Dong-quan/ESP32_IoT_Smart_Controller/Bai11.step

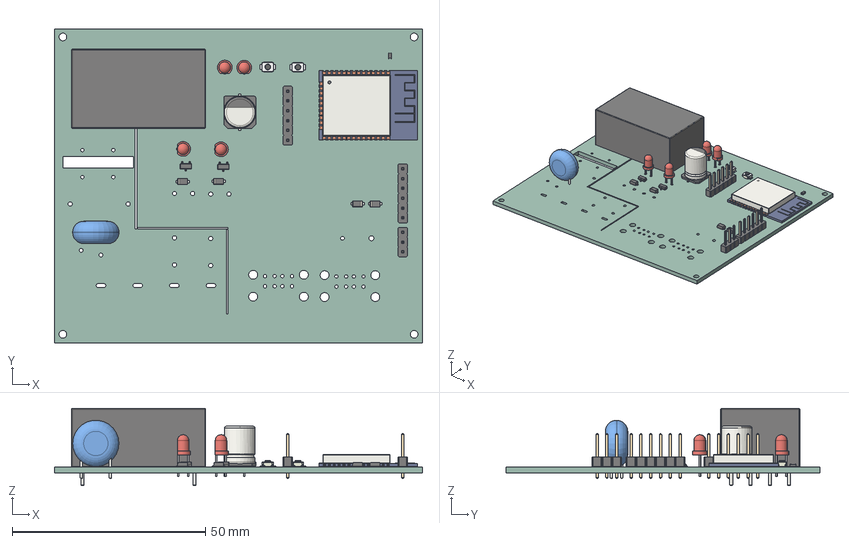
[picture p5: CAD file, 2026-10-30]
Bai11.step
95.3 x 81.3 x 20.0 mm
CP_Elec_8x10.5
ESP32-WROOM-32
SOT-23 x 2
D_SOD-123F x 4
RV_Disc_D12mm_W5.8mm_P7.5mm
LED_D3.0mm x 4
Converter_ACDC_Hi-Link_HLK-PMxx
SW_SPST_B3U-1000P x 2
D_0603_1608Metric
PinHeader_1x06_P2.54mm_Vertical x 2
PinHeader_1x03_P2.54mm_Vertical
Bai11_PCB
