Dong-quan/ESP32_IoT_Smart_Controller/Bai11.pdf

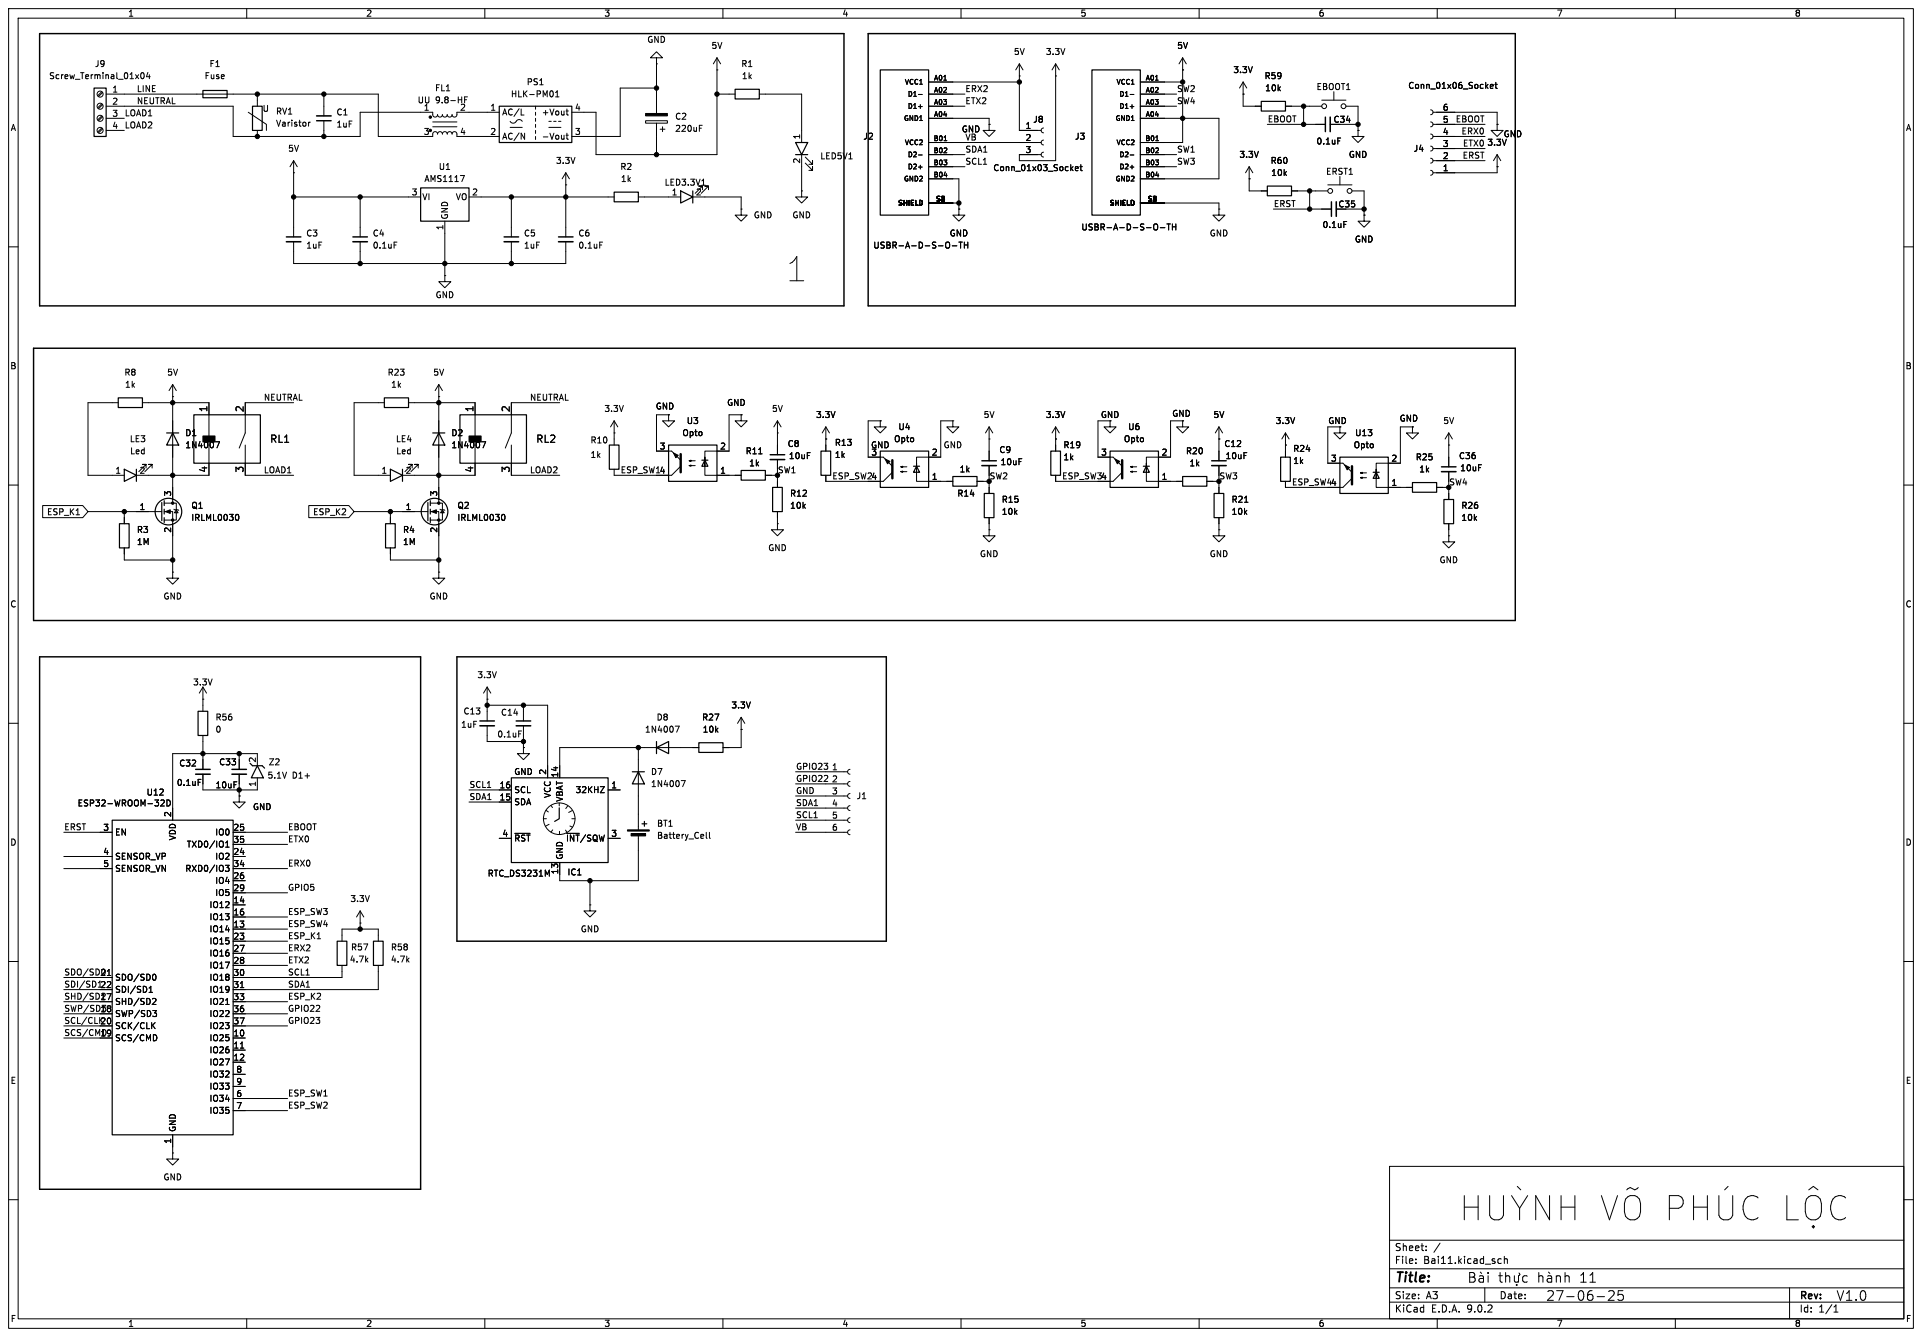
[picture p6: page 1]

þÿHUòNH þÿVÕþÿPHÚC þÿLØC
