Dong-quan/ESP32_IoT_Smart_Controller/Bai11.kicad_pcb

## KiCad design Bai11.kicad_pcb (2026-10-30)

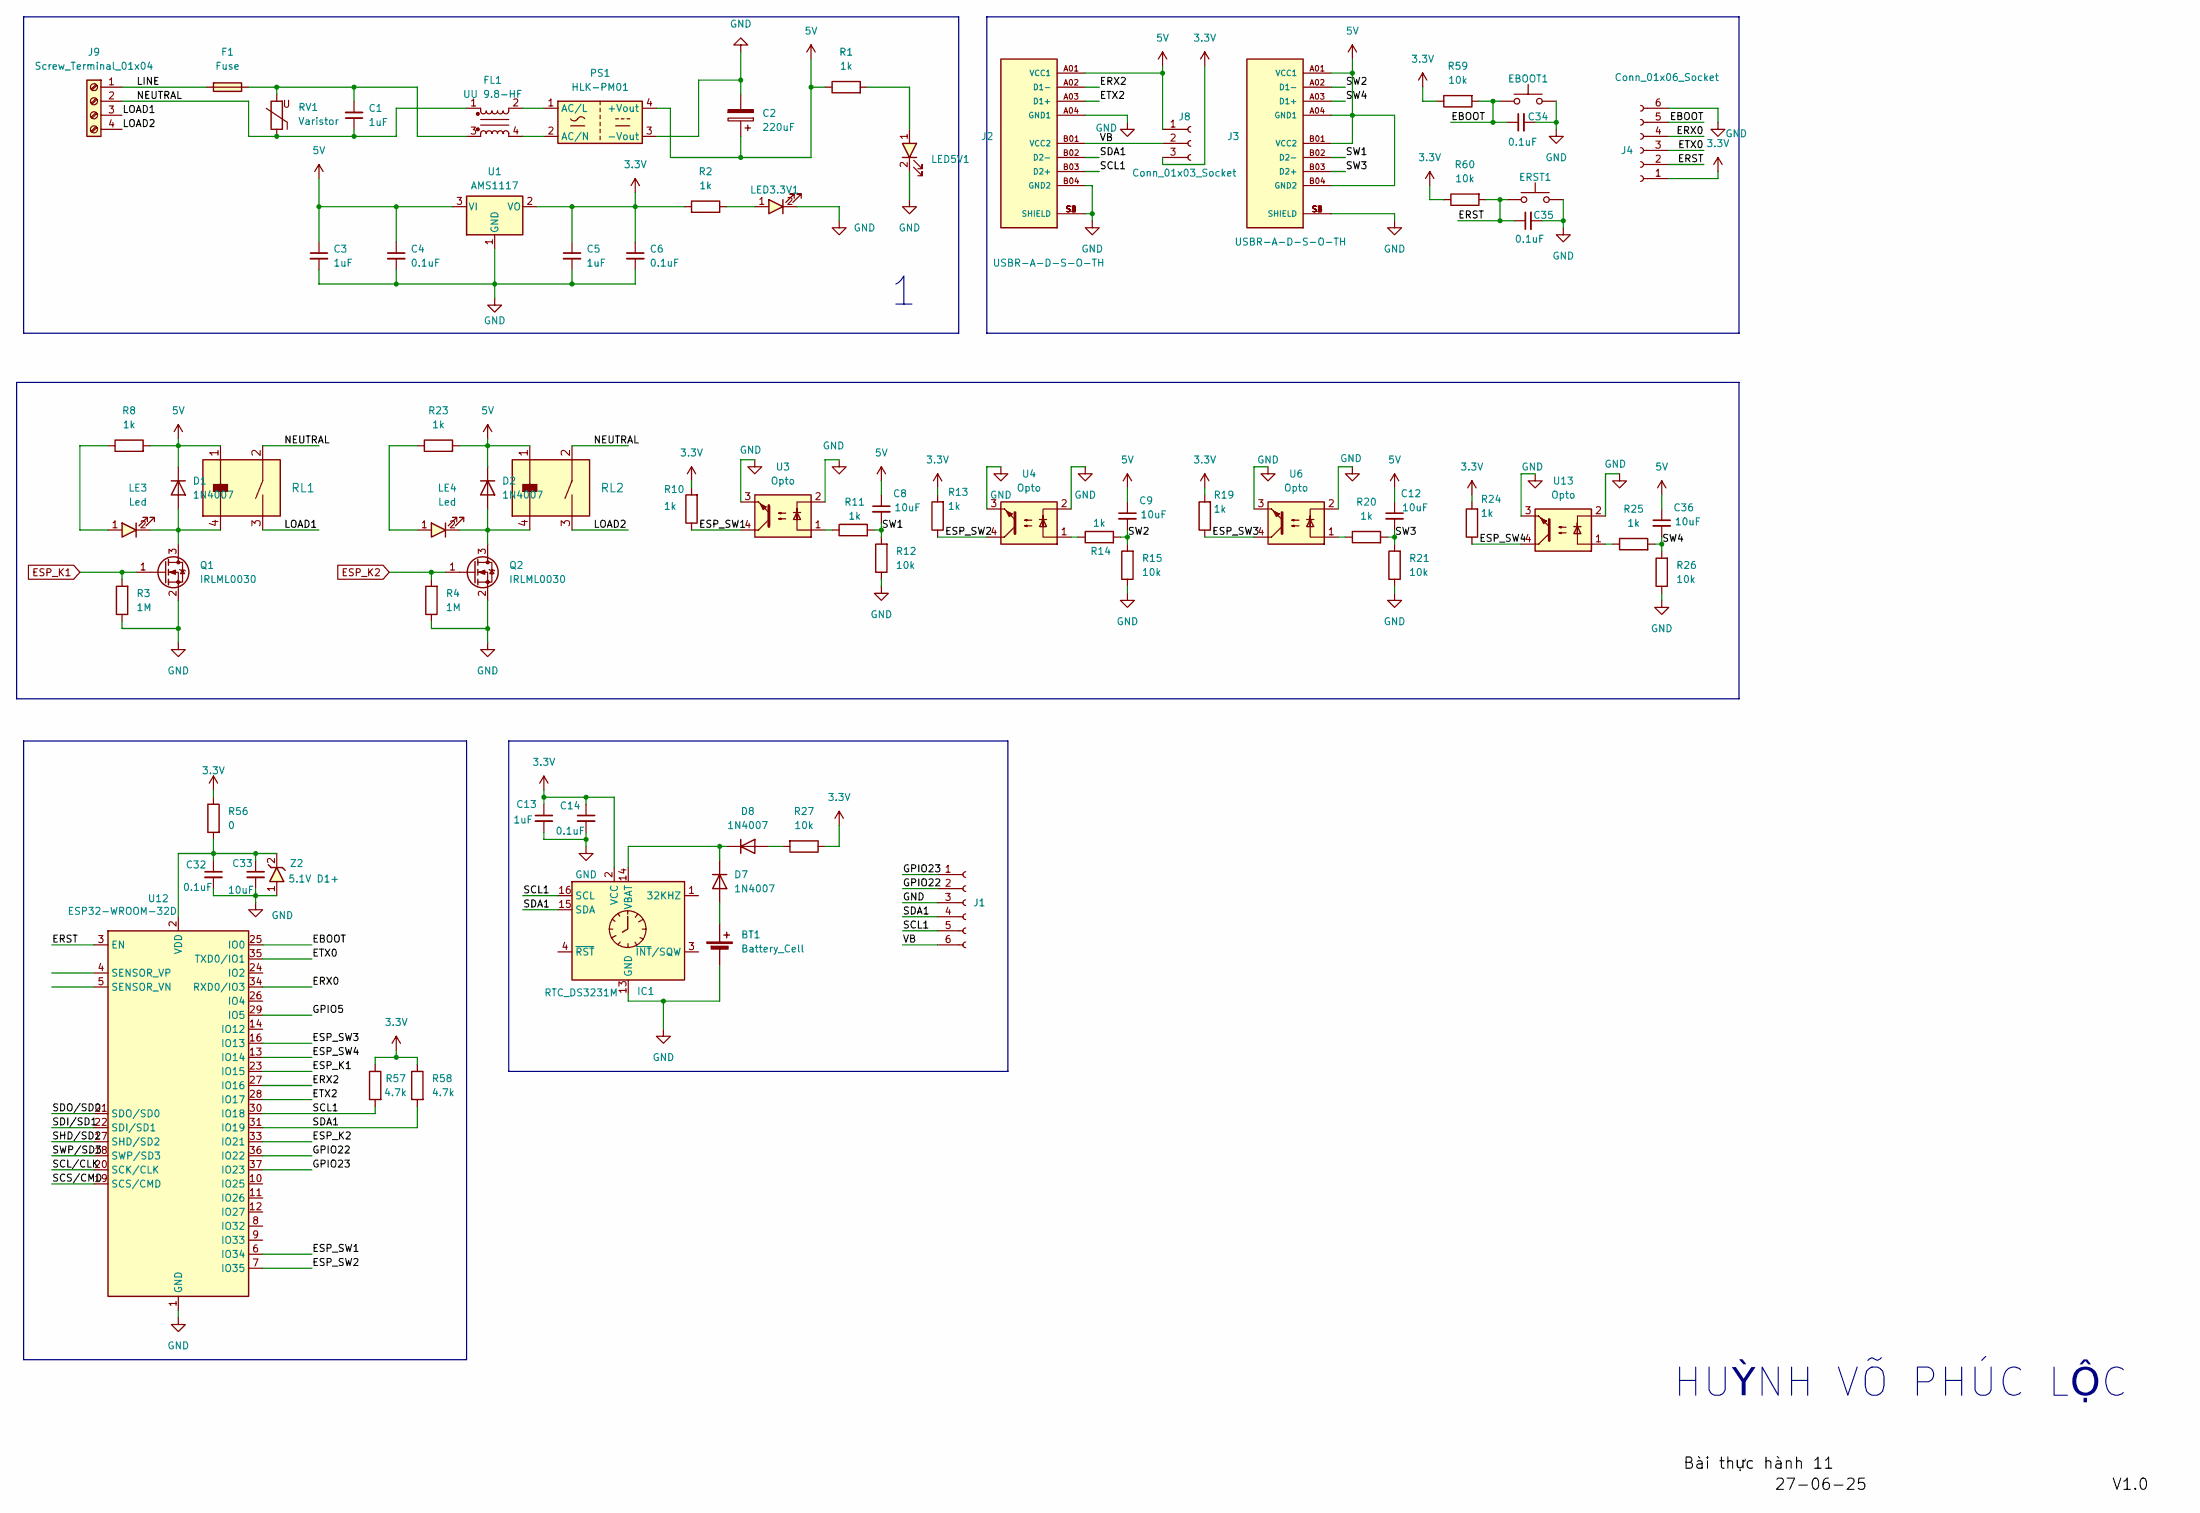
[picture p7: schematic Bai11.kicad_sch]

Parts:
BT1: Battery_Cell; BatteryHolder-SMD-CR1220
C1: 1uF; C-Polyester-Rect-L16.5mm-W5.0mm-P15.00mm-MKT
C2: 220uF; CP_Elec_8x10.5
C3, C5, C13: 1uF; C_0603
C4, C6, C14, C32, C34, C35: 0.1uF; C_0603
C8, C9, C12, C33, C36: 10uF; C_0603
D1, D2, D7, D8: 1N4007; D_SOD-123F
EBOOT1: SW_SPST_B3U-1000P
ERST1: SW_SPST_B3U-1000P
F1: Fuse; Fuse_Bourns_MF-RG300
FL1: UU 9.8-HF; ACFilterChoke-UU9.8
IC1: RTC_DS3231M; SOIC-16W_7.5x10.3mm_P1.27mm
J1, J4: Conn_01x06_Socket; PinHeader_1x06_P2.54mm_Vertical
J2, J3: USBR-A-D-S-O-TH; SAMTEC_USBR-A-D-S-O-TH
J8: Conn_01x03_Socket; PinHeader_1x03_P2.54mm_Vertical
J9: Screw_Terminal_01x04; TerminalBlock-Vert-THT-4P-P9.5mm-Screw_HB9500
LE3, LE4: Led; LED_D3.0mm
LED3.3V1, LED5V1: Led; LED_D3.0mm
PS1: HLK-PM01; Converter_ACDC_Hi-Link_HLK-PMxx
Q1, Q2: IRLML0030; SOT-23
R1, R2, R8, R10, R11, R13, R14, R19, R20, R23, R24, R25: 1k; R_0603
R3, R4: 1M; R_0603
R12, R15, R21, R26, R27, R59, R60: 10k; R_0603
R56: 0; R_0603
R57, R58: 4.7k; R_0603
RL1, RL2: Relay_G5NB-1A-E_DC5; Relay-G5NB_1A_E_DC5
RV1: Varistor; Varistor-RV-Disc-D12mm-W5.8mm-P7.5mm
U1: AMS1117; SOT233
U3, U4, U6, U13: Opto; OptoIsolation-EL357N-G
U12: ESP32-WROOM-32D; ESP32-WROOM-32E
Z2: 5.1V D1+; D_0603_1608Metric

Connections:
3.3V: C5.1, C6.1, C13.1, C14.1, IC1.2 (VCC), J4.1, J8.3, R2.1, R10.2, R13.2, R19.2, R24.2, R27.1, R56.1, R57.1, R58.1, R59.1, R60.1, U1.2 (VO)
5V: C2.1, C3.1, C4.1, C8.1, C9.1, C12.1, C36.1, D1.1 (K), D2.1 (K), J2.A01 (VCC1), J3.A01 (VCC1), J3.A04 (GND1), J3.B01 (VCC2), J3.B04 (GND2), J8.1, PS1.4 (+Vout), R1.1, R8.2, R23.2, RL1.1, RL2.1, U1.3 (VI)
/EBOOT: C34.1, EBOOT1.1, J4.5, R59.2, U12.25 (IO0)
/ERST: C35.1, ERST1.1, J4.2, R60.2, U12.3 (EN)
/ERX0: J4.4, U12.34 (RXD0/IO3)
/ERX2: J2.A02 (D1-), U12.27 (IO16)
/ESP_SW1: R10.1, U3.4, U12.6 (IO34)
/ESP_SW2: R13.1, U4.4, U12.7 (IO35)
/ESP_SW3: R19.1, U6.4, U12.16 (IO13)
/ESP_SW4: R24.1, U12.13 (IO14), U13.4
/ETX0: J4.3, U12.35 (TXD0/IO1)
/ETX2: J2.A03 (D1+), U12.28 (IO17)
/GPIO5: U12.29 (IO5)
/GPIO22: J1.2, U12.36 (IO22)
/GPIO23: J1.1, U12.37 (IO23)
/LINE: F1.1, J9.1
/LOAD1: J9.3, RL1.3
/LOAD2: J9.4, RL2.3
/NEUTRAL: C1.1, FL1.1, J9.2, RL1.2, RL2.2, RV1.1
/SCL1: IC1.16 (SCL), J1.5, J2.B03 (D2+), R57.2, U12.30 (IO18)
/SCL/CLK: U12.20 (SCK/CLK)
/SCS/CMD: U12.19 (SCS/CMD)
/SDA1: IC1.15 (SDA), J1.4, J2.B02 (D2-), R58.2, U12.31 (IO19)
/SDI/SD1: U12.22 (SDI/SD1)
/SDO/SD0: U12.21 (SDO/SD0)
/SHD/SD2: U12.17 (SHD/SD2)
/SW1: C8.2, J3.B02 (D2-), R11.2, R12.2
/SW2: C9.2, J3.A02 (D1-), R14.2, R15.2
/SW3: C12.2, J3.B03 (D2+), R20.2, R21.2
/SW4: C36.2, J3.A03 (D1+), R25.2, R26.2
/SWP/SD3: U12.18 (SWP/SD3)
/VB: J1.6, J2.B01 (VCC2), J8.2
ESP_K1: Q1.1 (G), R3.2, U12.23 (IO15)
ESP_K2: Q2.1 (G), R4.2, U12.33 (IO21)
GND: BT1.2 (-), C2.2, C3.2, C4.2, C5.2, C6.2, C13.2, C14.2, C32.2, C33.2, C34.2, C35.2, EBOOT1.2, ERST1.2, IC1.5 (GND), IC1.6 (GND), IC1.7 (GND), IC1.8 (GND), IC1.9 (GND), IC1.10 (GND), IC1.11 (GND), IC1.12 (GND), IC1.13 (GND), J1.3, J2.A04 (GND1), J2.B04 (GND2), J2.S1 (SHIELD), J2.S2 (SHIELD), J2.S3 (SHIELD), J2.S4 (SHIELD), J3.S1 (SHIELD), J3.S2 (SHIELD), J3.S3 (SHIELD), J3.S4 (SHIELD), J4.6, LED3.3V1.2, LED5V1.2, PS1.3 (-Vout), Q1.2 (S), Q2.2 (S), R3.1, R4.1, R12.1, R15.1, R21.1, R26.1, U1.1 (GND), U3.2, U3.3, U4.2, U4.3, U6.2, U6.3, U12.1 (GND), U12.15 (GND), U12.38 (GND), U12.39 (GND), U13.2, U13.3, Z2.1
unnamed: BT1.1 (+), D7.2 (A)
unnamed: C1.2, F1.2, FL1.3, RV1.2
unnamed: D1.2 (A), LE3.2, Q1.3 (D), RL1.4
unnamed: D2.2 (A), LE4.2, Q2.3 (D), RL2.4
unnamed: D7.1 (K), D8.1 (K), IC1.14 (VBAT)
unnamed: D8.2 (A), R27.2
unnamed: LE3.1, R8.1
unnamed: LE4.1, R23.1
unnamed: LED3.3V1.1, R2.2
unnamed: LED5V1.1, R1.2
unnamed: FL1.2, PS1.1 (AC/L)
unnamed: FL1.4, PS1.2 (AC/N)
unnamed: R11.1, U3.1
unnamed: R14.1, U4.1
unnamed: R20.1, U6.1
unnamed: R25.1, U13.1
unnamed: C32.1, C33.1, R56.2, U12.2 (VDD), Z2.2

Notes on the sheet:
HUỲNH VÕ PHÚC LỘC

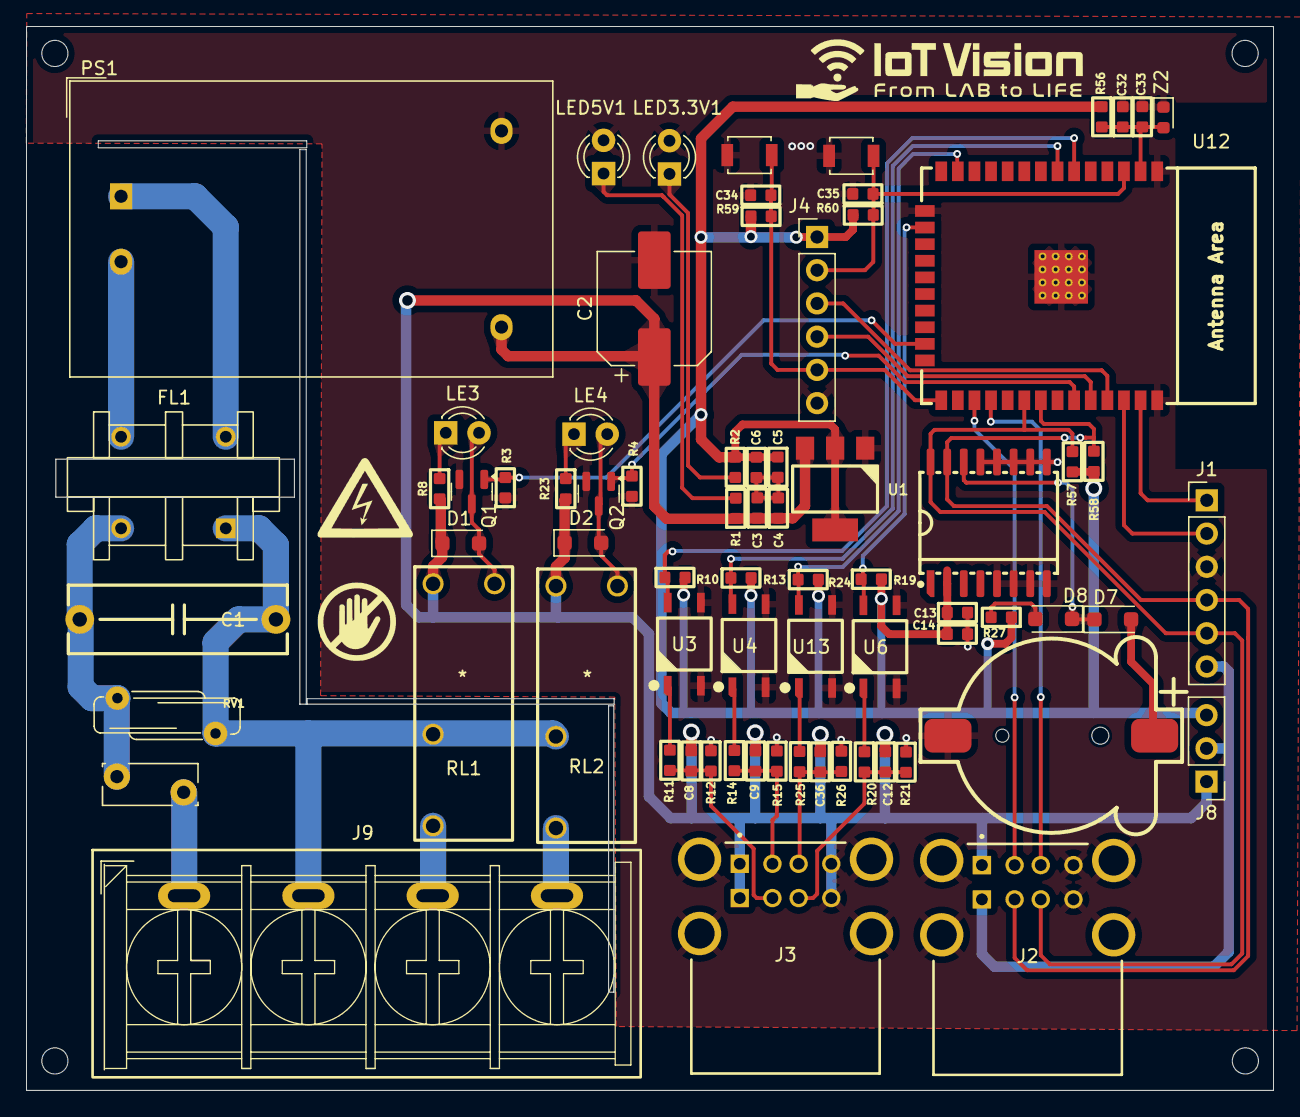
[picture p8: board Bai11.kicad_pcb from above]

Board: 2 copper layers, 95.3 x 81.3 mm, 73 parts (0 on the bottom side), 45 nets.
